rikaken2004/stm32-counter-motor-control_V3.0/FOOTPRINT_CHECKLIST.md

# FOOTPRINT CHECKLIST — 嘉立创 EDA 画板前封装确认

> 使用前请**逐项打勾**。每一项都必须在嘉立创 EDA 开始画符号/封装之前确认完毕。
> 所有信号名称以源代码 `hardware/*.c` 和 `user/*.c` 为准。

---

## 一、必须实物确认的模块

### 1. STM32F103C8T6 核心板 (Blue Pill / 兼容)

| # | 确认项 | 实测值/照片 | 已确认 |
|---|---|---|---|
| 1.1 | 排针 Pin 数: 2×20 = 40Pin | 标准 Blue Pill 为 2×20 | ☐ |
| 1.2 | 两排间距: 约 22.86mm (0.9 inch) | 卡尺实测 | ☐ |
| 1.3 | 排针间距: 2.54mm | 标准 2.54 | ☐ |
| 1.4 | **每个引脚的物理位置是否与原理图符号一致** | 拍照左右两侧排针，标注 Pin1 | ☐ |
| 1.5 | USB 口朝向 | 朝外/朝内？决定核心板摆放方向 | ☐ |
| 1.6 | BOOT0 / BOOT1 跳线位置 | 标注在照片上 | ☐ |
| 1.7 | RESET 按键位置 | 是否被 OLED / 其他模块遮挡？ | ☐ |
| 1.8 | SWD 口位置 (PA13/SWDIO, PA14/SWCLK) | 是否需要在 PCB 上再引出 SWD 排针？ | ☐ |
| 1.9 | 是否在 PCB 丝印上标注核心板方向 | 建议画一个箭头 + "USB→" | ☐ |

> **源代码验证**: 当前代码使用 PB8/PB9/PB12/PB13/PB14/PB1 (GPIOB), PA6/PA9/PA10 (GPIOA), PC13 (GPIOC)。均为 STM32F103C8T6 LQFP48 标准引脚。Blue Pill 引出全部 40 个 I/O。

### 2. TB6612FNG 电机驱动模块

| # | 确认项 | 实测值/照片 | 已确认 |
|---|---|---|---|
| 2.1 | 模块总排针数 | 拍照正面，标注每根针的功能 | ☐ |
| 2.2 | VM (电机电源) 位置 | 电压范围？(典型 2.5V~13.5V) | ☐ |
| 2.3 | VCC (逻辑电源) 位置 | 接 3.3V 还是 5V？ | ☐ |
| 2.4 | GND 位置 | 至少 1 个 GND 引脚 | ☐ |
| 2.5 | PWMA 位置 | 接 STM32 PA6 (TIM3_CH1) | ☐ |
| 2.6 | AIN1 位置 | 接 STM32 PB12 | ☐ |
| 2.7 | AIN2 位置 | 接 STM32 PB13 | ☐ |
| 2.8 | STBY 位置 | **代码未控制此引脚**，需确认模块是否已默认拉高 | ☐ |
| 2.9 | 如果 STBY 未默认拉高 | 需在 PCB 上接到 3.3V/VCC，或使用跳线帽 | ☐ |
| 2.10 | AO1/AO2 位置 | 电机输出 A 通道 | ☐ |
| 2.11 | 电机输出端位置 | 是否需要额外 2P 接线端子引出？ | ☐ |
| 2.12 | B 通道引脚 (BIN1/BIN2/PWMB/BO1/BO2) 位置 | V1 不使用 B 通道，标注为 NC | ☐ |

> **源代码验证**: `hardware/Motor.c:31-33`:
> - 正转/停止: PB12=H, PB13=L, `PWM_SetCompare1(Speed)` → PA6 PWM 占空比 = Speed%
> - 反转: PB12=L, PB13=H, `PWM_SetCompare1(-Speed)`
> - `PWM_Init()` 配置 TIM3_CH1 (PA6), ARR=99 → PWM 频率 ≈ 1kHz

### 3. OLED 0.96 寸 I2C 显示屏

| # | 确认项 | 实测值/照片 | 已确认 |
|---|---|---|---|
| 3.1 | **4Pin 引脚顺序（关键！）** | GND/VCC/SCL/SDA 还是 VCC/GND/SCL/SDA？ | ☐ |
| 3.2 | 拍照确认 Pin1 标识 | 丝印上通常有 VCC/GND 标记 | ☐ |
| 3.3 | 供电电压 | 3.3V 是否可正常点亮？还是必须 5V？ | ☐ |
| 3.4 | 接口方向 | 排针朝外还是朝上？方便杜邦线插拔 | ☐ |
| 3.5 | PCB 上 OLED 位置 | 是否考虑 4Pin 接口旁边标注 "GND/VCC/SCL/SDA" 丝印 | ☐ |

> **源代码验证**: `hardware/OLED.c:5-6`:
> - PB8 = SCL (`OLED_W_SCL(x) → GPIOB, Pin_8`)
> - PB9 = SDA (`OLED_W_SDA(x) → GPIOB, Pin_9`)
> - 配置为 `GPIO_Mode_Out_OD`（开漏输出，软件 I2C），无硬件 I2C 外设
>
> ⚠ 注意: 不同厂商 OLED 模块排针顺序不同！**必须拍照实物确认 Pin1 是 GND 还是 VCC，反接可能烧模块。**

### 4. 红外计数传感器

| # | 确认项 | 实测值/照片 | 已确认 |
|---|---|---|---|
| 4.1 | 3Pin 顺序 | VCC / GND / OUT | ☐ |
| 4.2 | 模块型号 | 红外对射？反射式？槽型光耦？ | ☐ |
| 4.3 | 供电电压 | 3.3V 还是 5V？ | ☐ |
| 4.4 | OUT 默认电平 | **高电平**（未触发），触发后**拉低** | ☐ |
| 4.5 | OUT 信号类型 | 数字开关量（非模拟） | ☐ |
| 4.6 | 是否需要 PB14 串联 1kΩ | 建议预留 0805 焊盘 | ☐ |
| 4.7 | 是否需要 PB14 上拉 10kΩ | 源码已配置内部上拉 (GPIO_IPU ≈ 40kΩ)，外部作为加固可选 | ☐ |
| 4.8 | 传感器安装方式 | 固定在 PCB 上还是外接延长线？ | ☐ |

> **源代码验证**: `hardware/CountSensor.c`:
> - 配置为 `GPIO_Mode_IPU`（内部上拉输入）
> - EXTI14 触发方式: `EXTI_Trigger_Falling`（下降沿）
> - ISR 中二次确认: `GPIO_ReadInputDataBit(GPIOB, GPIO_Pin_14) == 0`
> - **结论**: 红外传感器 OUT 默认高电平，检测到物体后拉低 → 下降沿触发计数。兼容 NPN 开集输出和推挽低有效输出。

### 5. USB-TTL 调试接口

| # | 确认项 | 说明 | 已确认 |
|---|---|---|---|
| 5.1 | 接口排针: GND / TX / RX / 3.3V | 4Pin 或 3Pin (无 3.3V) | ☐ |
| 5.2 | **丝印标注规则（关键！）** | `PB10_TX` = STM32 发送端 → 接 USB-TTL **RXD** | ☐ |
| 5.3 | | `PB11_RX` = STM32 接收端 → 接 USB-TTL **TXD** | ☐ |
| 5.4 | GND 丝印 | 清晰标注 | ☐ |
| 5.5 | 3.3V 丝印 | 标注 "3.3V (可选，通常不接)" | ☐ |
| 5.6 | **禁止丝印** | 不要标注 5V，防止误接烧 STM32 | ☐ |
| 5.7 | **不要从 USB-TTL 给 STM32 供电** | 在丝印上加注 "DO NOT POWER FROM UART" | ☐ |

> **源代码验证**: `user/uart_debug.c:11-15`: PB10 配置为 `GPIO_Mode_AF_PP` (USART3_TX), PB11 配置为 `GPIO_Mode_IN_FLOATING` (USART3_RX)。当前 TX 活跃使用，RX 初始化但未使用中断接收。

### 6. 电机接口

| # | 确认项 | 说明 | 已确认 |
|---|---|---|---|
| 6.1 | 接线端子类型 | 2P 螺钉端子 (5.08mm 或 3.5mm 间距) | ☐ |
| 6.2 | MOTOR_A+ → TB6612 AO1 | 丝印标注 "M+" | ☐ |
| 6.3 | MOTOR_A- → TB6612 AO2 | 丝印标注 "M-" | ☐ |
| 6.4 | 端子方向 | 朝板边，方便螺丝刀操作 | ☐ |
| 6.5 | 电机两端是否预留 0.1μF 电容焊盘 | 0805 或直插，直接并联在端子上 | ☐ |

> **源代码验证**: `hardware/Motor.c:29-41`: 电机方向由 PB12/PB13 控制，速度由 PA6 PWM 控制。M+/M- 只是功率输出，与代码无关。

### 7. 电机电源接口

| # | 确认项 | 说明 | 已确认 |
|---|---|---|---|
| 7.1 | 接线端子类型 | 2P 螺钉端子 (5.08mm 或 3.5mm 间距) | ☐ |
| 7.2 | VM 正极 | 丝印标注 "VM+" 或 "MOTOR_VCC" | ☐ |
| 7.3 | GND 负极 | 丝印标注 "GND" | ☐ |
| 7.4 | 电解电容位置 | 靠近 VM/GND 端子，径向引线封装 | ☐ |
| 7.5 | 电解电容值 | 100μF~470μF / 16V 或更高 | ☐ |
| 7.6 | 陶瓷电容位置 | 紧贴 VM/GND，0805 0.1μF | ☐ |
| 7.7 | 丝印标注电容极性 | 电解电容正极标 "+" | ☐ |
| 7.8 | 端子方向 | 朝板边 | ☐ |

### 8. 按键和 LED

| # | 确认项 | 说明 | 已确认 |
|---|---|---|---|
| 8.1 | PB1 ADD 按键封装 | 6×6mm 轻触开关 (4Pin 直插) | ☐ |
| 8.2 | PC13 CONFIRM/RESET 按键封装 | 6×6mm 轻触开关 (4Pin 直插) | ☐ |
| 8.3 | 按键是否需外部上拉 | **不需要**。源码已配置 GPIO_IPU (内部上拉 ≈40kΩ) | ☐ |
| 8.4 | 可预留 10kΩ 上拉焊盘 | 0805，默认不焊 | ☐ |
| 8.5 | PA9 LED9 (计数指示) | 5mm LED 直插，或者 0805 贴片 LED | ☐ |
| 8.6 | PA10 LED10 (状态指示) | 同上 | ☐ |
| 8.7 | **LED 点亮方式** | 低电平亮。PA9/PA10 输出低 → LED 导通 | ☐ |
| 8.8 | LED 限流电阻 | 220Ω~470Ω（3.3V 供电, 5mm 红色 LED, Vf≈1.8V, If≈5mA→R≈300Ω） | ☐ |
| 8.9 | LED 和电阻位置 | 靠近板边，方便观察 | ☐ |

> **源代码验证**:
> - `hardware/Key.c:16-17`: PB1 和 PC13 均配置 `GPIO_Mode_IPU`（内部上拉）。按键接 GND，按下时拉低。
> - `hardware/LED.c:40,104`: `GPIO_ResetBits(GPIOA, GPIO_Pin_9)` = 低电平 = LED **亮**; `GPIO_SetBits(GPIOA, GPIO_Pin_9)` = 高电平 = LED **灭**。

---

## 二、嘉立创 EDA 中建议的封装类型

| 元件 | 建议封装 | 嘉立创 EDA 搜索关键词 | 备注 |
|---|---|---|---|
| STM32 核心板排母 (单排) | 1×20Pin 排母, 2.54mm | `HDR-20X1-2.54` 或 `排母 1*20` | 需要 2 个 |
| STM32 核心板排母 (双排) | 2×20Pin 排母, 2.54mm | `HDR-20X2-2.54` 或 `排母 2*20` | 如用一体双排排母 |
| TB6612 模块排母 | 根据实测 Pin 数和排列 | `排母 1*N` | 拍照确认后再选 |
| OLED 4Pin 接口 | 1×4Pin 排针, 2.54mm | `HDR-4X1-2.54` | 或直接用排母 |
| 红外传感器 3Pin 接口 | 1×3Pin 排针, 2.54mm | `HDR-3X1-2.54` | 或 XH2.54-3P 弯针 |
| UART 调试接口 | 1×4Pin 排针, 2.54mm | `HDR-4X1-2.54` | 弯针或直针 |
| 电机接线端子 | 2P 螺钉端子, 5.08mm | `端子 5.08 2P` 或 `KF301-2P` | 两套: 电机输出 + 电机电源 |
| 按键 | 6×6mm 轻触开关, 4Pin | `轻触开关 6*6` 或 `TS-1187` | 2 个 |
| LED (直插) | 5mm LED, 2Pin | `LED 5mm` 或 `LED-TH-5MM` | 2 个 |
| LED (贴片) | 0805 LED | `LED-0805` | 备选 |
| 限流电阻 | 0805 或 直插 1/4W | `R-0805` 或 `RES-AXIAL` | 220Ω~470Ω |
| 电解电容 | 径向引线, Ø8~10mm | `CAP-ALU-RADIAL` | 100μF~470μF |
| 0.1μF 电容 | 0805 | `C-0805` | 或 直插 104 |
| PB14 串联电阻 | 0805 1kΩ | `R-0805` | 预留 |
| 测试点 | 1×1Pin 排针 或 测试环 | `测试点` 或 `TEST-POINT` | ~6 个 |

---

## 三、画板前必须拍照/测量清单

> 以下照片用于在 EDA 中绘制正确的封装和确认接口方向。

| # | 拍照/测量项 | 用途 | 已拍 |
|---|---|---|---|
| 3.1 | **STM32 核心板正面 + 背面** | 标注每个引脚的物理位置，确认 Pin1 | ☐ |
| 3.2 | **STM32 核心板侧面** | 测量两排排针间距（卡尺） | ☐ |
| 3.3 | **TB6612 模块正面 + 背面** | 标注每个引脚功能 (VM/VCC/GND/PWMA/AIN1/AIN2/STBY/AO1/AO2) | ☐ |
| 3.4 | **OLED 模块接口特写** | 看清 Pin1 标识和 GND/VCC/SCL/SDA 顺序 | ☐ |
| 3.5 | **红外传感器模块正反面** | 标注 VCC/GND/OUT 顺序 | ☐ |
| 3.6 | **USB-TTL 模块接口** | 确认 TXD/RXD/GND/3.3V/5V 标注方式 | ☐ |
| 3.7 | **电机 + 电机驱动板连接现状** | 参考当前杜邦线连接方式 | ☐ |
| 3.8 | **所有模块放在一起的俯视图** | 参考大致的物理布局 | ☐ |
| 3.9 | **卡尺/尺子放在旁边做比例参考** | 辅助确定 PCB 尺寸 | ☐ |

---

## 四、最容易画错的地方

| # | 风险项 | 后果 | 防范措施 |
|---|---|---|---|
| 4.1 | **核心板排母镜像** | 所有引脚左右互换，PCB 报废 | 拍照确认实物；EDA 中 3D 预览核对 Pin1 位置 |
| 4.2 | **OLED VCC/GND 反接** | 烧 OLED 模块 | 拍照确认 Pin1；丝印标注 GND 位置 |
| 4.3 | **TB6612 VM / VCC 混淆** | VM 接 3.3V 驱动不了电机；VCC 接 12V 烧模块 | 原理图中用不同网络名: `VMOTOR` vs `+3.3V` |
| 4.4 | **TX/RX 命名混淆** | 串口无输出 | 丝印标注 "PB10_TX → 接 USB-TTL RXD" |
| 4.5 | **电机电源和逻辑电源混淆** | 烧 STM32 或驱动无力 | 原理图中电源网络隔离；PCB 上分区走线 |
| 4.6 | **GND 未共地** | 电机不转或计数异常 | 原理图中所有 GND 为同一网络；PCB 上单点共地 |
| 4.7 | **电解电容极性反** | 电容爆裂 | 丝印标注 "+"；PCB 封装正极焊盘为方形 |
| 4.8 | **接线端子方向朝内** | 螺丝刀伸不进去 | 3D 预览确认端子开口朝板外 |
| 4.9 | **红外信号线与电机 PWM 线平行** | EMI 干扰重演 | PCB 布线后检查 PB14 走线不靠近 PA6/PB12/PB13 |
| 4.10 | **排母引脚编号与原理图符号不一致** | 所有信号错位 | EDA 原理图符号必须对照实物引脚编号 |
| 4.11 | **没有给 SWD 留测试点** | 无法烧录/调试 | 从核心板排母引 PA13/PA14 到 2Pin 排针（可选） |

---

## 五、下单前检查清单

> 嘉立创 EDA → 设计 → 设计规则检查 → 通过后逐项打勾。

### 电气规则 (ERC)

| # | 检查项 | 通过 |
|---|---|---|
| 5.1 | ERC 通过，0 错误 | ☐ |
| 5.2 | 所有电源网络有明确的源和负载 | ☐ |
| 5.3 | 无悬空输入引脚 (除了已预留的 NC) | ☐ |

### 设计规则 (DRC)

| # | 检查项 | 通过 |
|---|---|---|
| 5.4 | DRC 通过，0 错误 | ☐ |
| 5.5 | 最小线宽 ≥ 10mil (信号), ≥ 40mil (电源) | ☐ |
| 5.6 | 最小间距 ≥ 8mil | ☐ |
| 5.7 | 过孔尺寸 ≥ 0.6mm 内径 / 1.0mm 外径 | ☐ |

### 3D 预览

| # | 检查项 | 通过 |
|---|---|---|
| 5.8 | **STM32 核心板方向正确** — USB 口朝预期方向 | ☐ |
| 5.9 | OLED 排针顺序与实物一致 | ☐ |
| 5.10 | TB6612 排针顺序与实物一致 | ☐ |
| 5.11 | 接线端子开口朝板边 | ☐ |
| 5.12 | 按键不被 OLED 或其他模块遮挡 | ☐ |
| 5.13 | LED 位置可见（不被排针遮挡） | ☐ |

### 丝印

| # | 检查项 | 通过 |
|---|---|---|
| 5.14 | 电源正负极标注清晰 (VM+, GND, 3.3V, 5V) | ☐ |
| 5.15 | 电解电容正极标 "+" | ☐ |
| 5.16 | UART 接口: "PB10_TX → RXD", "PB11_RX ← TXD" | ☐ |
| 5.17 | 蜂鸣标注: "DO NOT POWER FROM UART" | ☐ |
| 5.18 | LED 标注: 低电平亮 | ☐ |

### 布局

| # | 检查项 | 通过 |
|---|---|---|
| 5.19 | 电机电源区和 MCU 区分区明显 | ☐ |
| 5.20 | 电机线靠板边，加粗走线 | ☐ |
| 5.21 | 红外接口远离电机 PWM / 电机电源走线 | ☐ |
| 5.22 | GND 铺铜 (顶层 + 底层) | ☐ |
| 5.23 | 电容靠近对应 IC/端子 | ☐ |

### 测试点

| # | 测试点 | 通过 |
|---|---|---|
| 5.24 | 3.3V | ☐ |
| 5.25 | GND (至少 2 个) | ☐ |
| 5.26 | PB14 (红外信号) | ☐ |
| 5.27 | PB10 (UART TX) | ☐ |
| 5.28 | PA6 (PWM) | ☐ |
| 5.29 | VM (电机电压) | ☐ |

---

*本文档状态: 所有项待确认。画原理图前务必完成第一章和第三章。*
