rikaken2004/stm32-counter-motor-control_V3.0/PROJECT_COMPLETION_CHECKLIST.md

# PROJECT COMPLETION CHECKLIST

## 一、项目最终定位

**项目名称**：STM32 智能计数与电机控制系统 —— 51 双 MCU 项目的 STM32 工程化升级版

**定位说明**：

| 维度 | 说明 |
|---|---|
| V1 目标 | 完成 STM32 单 MCU 工程化重构，实现原 51 双 MCU 的核心功能 |
| 显示方式 | V1 使用 OLED；数码管作为 V1.5/V2 扩展 |
| 双机通信 | 不在 V1 迁移。STM32 单 MCU 已能完成原双 51 的功能 |
| FreeRTOS | 不在 V1 合入。作为 V2 可选升级 |
| 非目标 | V1 不是完全复刻 51 的数码管和双机通信 |

## 二、V1 必须完成的功能清单

### 已完成 ✅

| # | 功能 | 状态 |
|---|---|---|
| 1 | OLED 显示目标值(T)、当前计数(C)、累计值(Total)、状态(State)、电机状态(Motor) | ✅ 已实现 |
| 2 | PB1 按键设置目标值 (0~99 循环) | ✅ 已实现 |
| 3 | PC13 短按确认/复位，长按复位 (>2s) | ✅ 已实现 |
| 4 | PB14 红外 EXTI 下降沿计数 | ✅ 已实现 |
| 5 | TIM4 1ms 非阻塞时基 (`App_Millis`) | ✅ 已实现 |
| 6 | app_key 非阻塞按键消抖 (10ms 采样, 3 次确认) | ✅ 已实现 |
| 7 | app.c IDLE / RUNNING / COOLDOWN 状态机 | ✅ 已实现 |
| 8 | TIM3 PWM 电机调速 (PA6, 60% 占空比, PB12/PB13 方向) | ✅ 已实现 |
| 9 | USART3 PB10/PB11 调试日志 (启动/按键/状态转换/IR 计数事件) | ✅ 已实现 |
| 10 | app 层 IR 120ms 防抖过滤 | ✅ 已实现 |
| 11 | PA9 LED 计数闪烁 (50ms), PA10 LED COOLDOWN 常亮 | ✅ 已实现 |
| 12 | COOLDOWN 5s 后自动重启电机进入下一轮 | ✅ 已实现 |

### 待完成 🔲

| # | 功能 | 状态 | 备注 |
|---|---|---|---|
| 13 | 电机接入后的抗干扰整改 | 🔲 待硬件处理 | 见第三章 |
| 14 | 稳定运行测试 (连续 10~30 分钟) | 🔲 待硬件整改后 | 见第七章 |

## 三、V1 硬件整改清单

> 所有项目均待执行。目标：消除电机对 PB14 红外计数的 EMI 干扰。

| # | 整改项 | 状态 | 说明 |
|---|---|---|---|
| 1 | 电机单独供电 | 🔲 | 电机驱动板 VM 使用独立电源，不与 STM32 共用 |
| 2 | STM32 与电机驱动共地 | 🔲 | GND 相连，但电源隔离 |
| 3 | 电机驱动 VM/GND 并联 100μF~470μF 电解电容 | 🔲 | 吸收电机启停电流尖峰 |
| 4 | VM/GND 附近并联 0.1μF 陶瓷电容 | 🔲 | 滤除高频噪声 |
| 5 | 电机两端并联 0.1μF 陶瓷电容 | 🔲 | 直接焊在电机接线端子上 |
| 6 | 红外 OUT → PB14 预留 1kΩ 串联电阻 | 🔲 | 限流 + 低通滤波 |
| 7 | PB14 预留 10kΩ 上拉到 3.3V | 🔲 | 确保无信号时电平确定 |
| 8 | 红外信号线远离电机线 | 🔲 | 物理隔离，避免平行走线 |
| 9 | 电机电源线加粗、缩短 | 🔲 | 减小回路阻抗和辐射面积 |
| 10 | GND 回流路径避免穿过 MCU 信号区 | 🔲 | 单点接地或星型接地 |

## 四、PCB V1 设计清单

> V1 定义为模块化载板，使用现成核心板 + 模块，非 STM32 裸芯片板。

### 板载接口 🔲

| # | 项目 | 状态 | 说明 |
|---|---|---|---|
| 1 | STM32F103C8T6 核心板插座 | 🔲 | 2×20 排母，接入 Blue Pill / 最小系统板 |
| 2 | TB6612FNG 电机驱动模块插座 | 🔲 | 排针/排母接口 |
| 3 | OLED 4Pin 接口 (VCC/GND/SCL/SDA) | 🔲 | 2.54mm 排针 |
| 4 | 红外传感器 3Pin 接口 (VCC/GND/OUT) | 🔲 | 2.54mm 排针 |
| 5 | PB1 按键 (ADD) | 🔲 | 微动开关 + 上拉电阻 |
| 6 | PC13 按键 (CONFIRM) | 🔲 | 微动开关 + 上拉电阻 |
| 7 | PA9 LED (计数指示) | 🔲 | 5mm LED + 限流电阻 |
| 8 | PA10 LED (冷却指示) | 🔲 | 5mm LED + 限流电阻 |
| 9 | USART3 调试接口 (PB10/PB11) | 🔲 | 4Pin (VCC/GND/TX/RX) 排针，兼容 USB-TTL |
| 10 | 电机接线端子 | 🔲 | 2P 螺钉端子 |
| 11 | 电机电源输入端子 | 🔲 | 2P 螺钉端子，独立供电 |
| 12 | 逻辑电源接口 | 🔲 | 5V 输入，为 STM32 核心板供电 |

### 电容预留位 🔲

| # | 位置 | 状态 |
|---|---|---|
| 13 | 电机电源输入端：100μF~470μF 电解电容焊盘 | 🔲 |
| 14 | 电机电源输入端：0.1μF 0805 陶瓷电容焊盘 | 🔲 |
| 15 | PB14 输入端：100nF 对地电容焊盘 | 🔲 |

### PCB 设计要求 🔲

| # | 项目 | 状态 |
|---|---|---|
| 16 | GND 铺铜 (顶层 + 底层) | 🔲 |
| 17 | 测试点：3.3V、5V、GND、PB14、PB10、PA6 | 🔲 |
| 18 | 嘉立创 EDA 设计，打样 10cm×10cm 以内 | 🔲 |

## 五、V1 不做清单

> 明确排除，避免范围蔓延。

| # | 项目 | 原因 |
|---|---|---|
| 1 | STM32 裸芯片板 | V1 用核心板+模块载板，降低门槛 |
| 2 | 板载 ST-LINK | 使用外接 ST-Link V2 / USB-TTL |
| 3 | 复杂电源管理 | V1 不做 DC-DC / LDO 电路，模块自带 |
| 4 | 数码管主显示 | V1 用 OLED；数码管放 V1.5 |
| 5 | 双 MCU 主从通信 | STM32 单 MCU 已覆盖原双 51 功能 |
| 6 | FreeRTOS 合入 | 放 V2，V1 保持裸机 |
| 7 | DMA 数码管扫描 | 无数码管则不需 |
| 8 | Flash 参数保存 | V1 参数不持久化，每次上电重置 |
| 9 | 外壳结构 | 仅做板级验证 |

## 六、V1.5 / V2 可选升级

### V1.5 — 显示扩展 🔲

| # | 项目 | 说明 |
|---|---|---|
| 1 | 数码管显示扩展 | 显示当前计数 / 目标值 |
| 2 | TM1637 方案 | 4 位 / 6 位数码管，I2C 类协议，2 线 |
| 3 | MAX7219 方案 | 8 位数码管，SPI，可级联 |
| 4 | 74HC595 方案 | 低成本，需 3 线 + 软件扫描 |
| 5 | 保留 OLED 主显示 | OLED 显示状态/菜单，数码管显示数值 |

### V2 — FreeRTOS 任务化 🔲

| # | 项目 | 说明 |
|---|---|---|
| 1 | FreeRTOS 移植 | CMSIS-RTOS v1/v2 API |
| 2 | KeyTask | 按键扫描任务，发送事件到 Queue |
| 3 | SensorTask | 红外计数任务，semaphore 通知 |
| 4 | MotorTask | 电机控制任务，接收速度/方向命令 |
| 5 | DisplayTask | OLED 刷新任务，100ms 周期 |
| 6 | DebugTask | UART 日志任务，Queue 接收消息后发送 |
| 7 | AppTask | 状态机任务，EventGroup 协调各任务 |
| 8 | UART 日志改队列发送 | 避免阻塞式 TX，解耦日志与发送 |
| 9 | 参数设置菜单 | OLED 菜单 + 按键导航，设置电机速度/冷却时间/目标上限 |

## 七、验证清单

### 基础功能测试

| # | 测试项 | 状态 | 通过条件 |
|---|---|---|---|
| 1 | 上电 OLED 显示正常 | 🔲 | 4 行内容清晰，State: IDLE, Motor: OFF |
| 2 | PB1 加值正常 | 🔲 | T 值 0→1→2...→99→0 循环 |
| 3 | PC13 短按启动 | 🔲 | T>0 时 RUNNING, 电机转动 |
| 4 | PC13 长按复位 | 🔲 | 任意状态 >2s 按回 IDLE |
| 5 | 红外计数正常 | 🔲 | PB14 有脉冲时 C 值递增 |
| 6 | 达标进入冷却 | 🔲 | C≥T 时电机停, LED10 亮, State: COOL |
| 7 | 冷却 5s 自动重启 | 🔲 | 5s 后自动回 RUNNING, 电机启动 |
| 8 | RUNNING 中复位 | 🔲 | 短按/长按均回 IDLE, 电机停 |
| 9 | COOLDOWN 中复位 | 🔲 | 短按/长按均回 IDLE, 电机停 |
| 10 | UART 日志正常 | 🔲 | 串口助手可收到 7 种事件日志 |

### 红外计数精度测试 (不接电机)

| # | 测试项 | 状态 | 通过条件 |
|---|---|---|---|
| 11 | 不接电机，红外计数稳定 | 🔲 | raw=1, 无异常跳变 |

### 电机 + 红外联合测试 (接电机)

| # | 测试项 | 状态 | 通过条件 |
|---|---|---|---|
| 12 | 接电机后红外无异常大脉冲 | 🔲 | raw 无 20+ 的异常值 |
| 13 | T=1 连续 10 轮 | 🔲 | 每轮正常完成, 无复位 |
| 14 | T=3 连续 10 轮 | 🔲 | 每轮正常完成, 无复位 |
| 15 | T=5 连续 10 轮 | 🔲 | 每轮正常完成, 无复位 |

### 稳定性测试

| # | 测试项 | 状态 | 通过条件 |
|---|---|---|---|
| 16 | OLED 无卡死 | 🔲 | 显示持续刷新, 无冻结/乱码 |
| 17 | UART 日志无异常 | 🔲 | 日志格式正确, 无乱码/丢帧 |
| 18 | 电机启停无复位 | 🔲 | 启停瞬间 STM32 不重启 |
| 19 | 连续运行 10~30 分钟 | 🔲 | 无异常复位/死机 |

## 八、简历交付物清单

| # | 交付物 | 状态 | 说明 |
|---|---|---|---|
| 1 | 项目 README | 🔲 | 项目概述、功能列表、硬件接线、编译烧录 |
| 2 | 状态机图 | 🔲 | IDLE→RUNNING→COOLDOWN 转换图 |
| 3 | 引脚表 PINMAP | 🔲 | 已存在于 PROJECT_CONTEXT.md |
| 4 | 原理图截图 | 🔲 | 嘉立创 EDA 导出 |
| 5 | PCB 3D 预览图 | 🔲 | 嘉立创 EDA 3D 视图截图 |
| 6 | 实物照片 | 🔲 | 模块搭建 + PCB 版本各一张 |
| 7 | 演示视频 | 🔲 | 完整工作流程: 设置→启动→计数→停止→冷却→重启 |
| 8 | 串口日志截图 | 🔲 | 包含 7 种事件日志的完整截图 |
| 9 | 电机干扰定位记录 | 🔲 | 干扰现象 + 整改方案 + 整改前后对比 |
| 10 | Git 本地提交记录 | 🔲 | 清晰的 commit history |

## 九、简历项目描述草稿

> 可用于简历「项目经历」栏，建议 4~6 行。

**STM32 智能计数与电机控制系统**

- 基于 STM32F103C8T6 的工业计数控制项目，是 51 双 MCU 方案的 STM32 单芯片工程化升级
- 设计 IDLE / RUNNING / COOLDOWN 三层非阻塞状态机，基于 TIM4 1ms 时基驱动，零 `Delay_ms` 裸机架构
- EXTI 下降沿红外脉冲计数 + 软件消抖，TIM3 PWM 电机调速 (TB6612 驱动)，按键消抖采用 10ms 采样 3 次确认状态机
- USART3 115200bps 事件日志 (启动/状态转换/计数/复位)，用于调试和运行监控
- 定位并整改电机 EMI 干扰红外信号问题：独立供电、RC 滤波、PCB 布局优化
- 使用 Keil MDK + STM32 标准外设库开发，嘉立创 EDA 设计模块化载板 PCB

**英文版 (可选)**：

- STM32F103C8T6-based industrial counting & motor control system; single-MCU upgrade from a dual-8051 design
- Designed a 3-state non-blocking state machine (IDLE→RUNNING→COOLDOWN) driven by TIM4 1ms tick, zero blocking delays
- EXTI-based IR pulse counting with software debounce; TIM3 PWM motor speed control via TB6612 driver
- USART3 115200bps event logging for debugging and runtime monitoring
- Diagnosed and resolved motor EMI interference on the IR sensor signal through isolated power, RC filtering, and PCB layout improvements
- Developed with Keil MDK + STM32 Standard Peripheral Library; modular carrier board PCB designed in EasyEDA

---

*本文档状态：规划中。V1 软件功能基本完成，硬件整改和验证待进行。*
