rikaken2004/stm32-counter-motor-control_V3.0/PROJECT_CONTEXT.md

# PROJECT CONTEXT — STM32 计数器项目

## 项目概述

基于 STM32F103 的计数/定长控制系统。传感器脉冲计数，达到目标值后电机自动停止，冷却后自动重启，循环运行。

## 目录结构

```
STM32_COUNTER_PROJECT/
└── 2-1/                          # Keil MDK 工程目录
    ├── project.uvprojx           # Keil 工程文件
    ├── user/                     # 应用层
    │   ├── main.c                # 入口
    │   ├── app.h / app.c         # 状态机 & 任务调度
    │   ├── app_time.h / app_time.c   # 非阻塞时基 (TIM4)
    │   ├── app_key.h / app_key.c     # 非阻塞按键
    │   ├── uart_debug.h / uart_debug.c  # USART3 调试输出
    │   ├── stm32f10x_conf.h
    │   └── stm32f10x_it.c/h
    ├── hardware/                 # 外设驱动（不可修改）
    │   ├── OLED.c/h, OLED_Font.h
    │   ├── Motor.c/h
    │   ├── PWM.c/h
    │   ├── LED.c/h, NEW_LED.c/h
    │   ├── Key.c/h
    │   ├── CountSensor.c/h
    │   ├── Encoder.c/h, NEW_Encoder.c/h
    │   ├── IC.c/h
    │   ├── AD.c/h, New_AD.c/h
    │   ├── Buzzer.c/h
    │   ├── LightSensor.c/h
    │   └── Servo.c/h
    ├── system/                   # 系统工具（已存在，应用中未使用）
    │   ├── Delay.c/h
    │   ├── Timer.c/h
    │   ├── InternalTimer.c/h
    │   └── ExternalTimer.c/h
    ├── start/                    # 启动文件 & CMSIS
    └── library/                  # 标准外设库
```

## 当前实现功能

| 功能 | 说明 |
|---|---|
| 非阻塞时基 | TIM4 1ms 中断，`App_Millis()` 提供毫秒时间戳 |
| 非阻塞按键 | PB1 加值, PC13 短按确认/长按复位(>2s), 10ms 采样 + 3 次消抖 |
| 状态机 | IDLE → RUNNING → COOLDOWN → RUNNING 自动循环 |
| OLED 显示 | 100ms 刷新, 4 行: 目标/当前/累计/状态/电机 |
| 电机控制 | PWM 调速 60%, PA6(TIM3_CH1), 方向 PB12/PB13 |
| 计数传感器 | PB14 下降沿中断, delta 差值法, app 层 120ms 防抖过滤 |
| LED 指示 | PA9 每检测到一次计数闪 50ms, PA10 COOLDOWN 时常亮 |
| USART3 调试日志 | 启动日志 + 按键/状态转换/IR 计数事件日志, 115200 8N1 |

## 新增文件

| 文件 | 作用 |
|---|---|
| `user/app_time.h` | `App_Time_Init()`, `App_Millis()` |
| `user/app_time.c` | TIM4 配置 (PSC=71, ARR=999, 1kHz), `TIM4_IRQHandler` tick 自增 |
| `user/app_key.h` | `AppKeyEvent` 枚举, `App_Key_Init/Update/GetEvent` |
| `user/app_key.c` | 非阻塞状态机: PB1 单次触发, PC13 短/长按, 事件缓存 |
| `user/app.h` | `App_Init()`, `App_Task()` |
| `user/app.c` | 三层状态机 + delta 计数 + IR 防抖 + OLED 刷新 + LED 指示 + 事件日志 |
| `user/uart_debug.h` | `UART_Debug_Init/SendChar/SendString/SendNum` |
| `user/uart_debug.c` | USART3 PB10/PB11, 阻塞式 TX, 115200 8N1 |

## 修改文件

| 文件 | 变更 |
|---|---|
| `user/main.c` | 旧 AD 演示替换为 `App_Init()` + `while(1) App_Task()` |
| `project.uvprojx` | 补加 `Motor.c/h` 到 hardware 组; `app_time/app_key/app/uart_debug` 到 user 组 |

## 状态机

```
         ┌──────────────────────────────┐
         │   CONFIRM / RESET            │
         │   (清零, 停电机)              │
         ▼                              │
      ┌──────┐  CONFIRM(target>0)  ┌──────────┐
      │ IDLE │ ──────────────────→ │ RUNNING  │
      │      │                     │ 电机 ON   │
      └──────┘                     └──────────┘
         ▲                              │
         │                              │ current ≥ target
         │                              ▼
         │                        ┌───────────┐
         │   CONFIRM / RESET      │ COOLDOWN  │
         └─────────────────────── │ 电机 OFF   │
                                  │ LED10 ON  │
                                  └───────────┘
                                       │
                                       │ 5s 后
                                       │ 自动重启电机
                                       ▼
                                  ┌──────────┐
                                  │ RUNNING  │  (下一轮)
                                  └──────────┘
```

- **IDLE**: PB1(ADD) 调整 target_count (0~99 循环)，PC13 短按启动 (target>0 时)，PC13 长按清零
- **RUNNING**: 电机 60% 占空比运行，CountSensor delta 累加 current_count（app 层 120ms 防抖），每有效脉冲 PA9 闪 50ms，达标→COOLDOWN。CONFIRM/RESET 清零回 IDLE
- **COOLDOWN**: 电机停止，LED10 亮，等 5s → 自动清零 current_count 回 RUNNING。CONFIRM/RESET 清零回 IDLE

## 硬件引脚分配

| 模块 | 引脚 | 备注 |
|---|---|---|
| OLED I2C | PB8(SCL), PB9(SDA) | 软件 I2C |
| 电机 PWM | PA6 (TIM3_CH1) | `Motor_Init` 内部调用 `PWM_Init` |
| 电机方向 | PB12, PB13 | 推挽输出, `Motor_SetSpeed` 控制 |
| 计数传感器 | PB14 (EXTI14 下降沿) | 上拉输入, `CountSensor_Init/Get` |
| 按键 ADD | PB1 | 上拉输入, 低电平有效 |
| 按键 CONFIRM | PC13 | 上拉输入, 低电平有效 |
| LED9 | PA9 | 推挽输出, 低电平亮 |
| LED10 | PA10 | 推挽输出, 低电平亮 |
| USART3 TX | PB10 | 复用推挽, 115200 8N1 |
| USART3 RX | PB11 | 浮空输入（已初始化，未使用接收） |
| 时基 | TIM4 | PSC=71, ARR=999, 1ms 中断 |

## UART 调试日志

波特率 115200, 8N1。USART3 (PB10/PB11)，仅 TX 发送。

| 事件 | 日志格式 |
|---|---|
| 系统启动 | `STM32 counter system boot` |
| 按键加值 | `KEY ADD target=xx` |
| 确认启动 | `STATE IDLE->RUN target=xx` |
| 红外有效计数 | `IR raw=xx count=xx` |
| 达标进入冷却 | `STATE RUN->COOL total=xxxxx` |
| 冷却结束重启 | `STATE COOL->RUN` |
| 任意状态复位 | `RESET to IDLE` |

## 已知问题：电机干扰

### 现象

- 接入电机电源后，电机启动/运行会严重干扰 PB14 红外计数输入
- 串口日志出现 `IR raw=25`、`IR raw=30` 等异常大脉冲
- 可能导致 STM32 异常复位或主循环卡死（OLED 熄屏、系统停止响应）
- 断开电机电源后，仅保留 STM32、OLED、红外、按键、USB-TTL，计数恢复正常（raw=1）

### 根因分析

电机 PWM 驱动产生电磁干扰（EMI），通过以下路径影响 PB14：

1. **传导干扰**：电机和 STM32 共用电源，电机启停产生电压波动
2. **辐射干扰**：电机换向火花/高频 PWM 通过电磁场耦合到 PB14 信号线
3. **地弹**：电机大电流在地线上产生电压差，干扰红外传感器参考电平

当前的 app 层 120ms 红外防抖只能过滤计数增量，无法阻止 ISR 层面的中断风暴。

### 临时处理

- 后续软件开发和逻辑测试时**先断开电机电源**
- 只保留 STM32、OLED、红外、按键、USB-TTL 测试主逻辑
- 电机相关逻辑可正常开发，但验证时以无电机环境为准

### 后续硬件处理计划

1. **电机单独供电** — 电机驱动板使用独立电源，不与 STM32 共用
2. **共地** — STM32 与电机驱动板 GND 相连（仅地线，电源隔离）
3. **电机驱动 VM/GND 并联电解电容** — 100μF~470μF，吸收电机启停电流尖峰
4. **电机两端并联陶瓷电容** — 0.1μF (104)，滤除换向火花高频噪声
5. **信号线远离电机线** — PB14 红外信号线远离电机驱动线和电机本体
6. **PB14 输入端 RC 滤波** — 串联 1kΩ 电阻 + 对地 100nF 电容 + 10kΩ 上拉
7. **软件兜底** — app 层已加入 `APP_IR_DEBOUNCE_MS=120ms` 最小计数间隔过滤

## 当前限制

1. **CountSensor 需要外部脉冲源** — PB14 无脉冲时计数不增长
2. **App_Task 中 GetEvent 在 Update 之前调用** — 按键事件有 1 帧延迟（非致命）
3. **LED ON/OFF 函数每次重新初始化 GPIO** — 功能正确但低效
4. **system/ 和部分 hardware/ 旧驱动未清理** — 可编译但未使用
5. **电机干扰未硬件解决** — 当前接电机时系统不稳定，需断开电机测试
6. **无 printf 重定向** — 日志使用逐字符阻塞发送，波特率 115200
7. **无 USART 中断/DMA** — TX 为轮询等待 TXE 标志位

## 下一阶段计划（勿执行）

1. 硬件：电机独立供电 + 滤波电容 + 信号线隔离
2. 硬件：PB14 输入 RC 滤波
3. 修复 App_Task 中 Update/GetEvent 调用顺序
4. 数码管显示方案
5. DMA + ADC 非阻塞模拟量采集
6. 清理未使用的旧驱动文件
7. 嘉立创 EDA 原理图/PCB 设计
8. 参数可配置（电机速度、冷却时间、目标上限）

---

## PCB V1 焊接与首次上电调试记录

**日期**：2026-06-04

### 背景

PCB V1 已完成嘉立创下单并收到裸板。V1 采用**模块化载板方案**（STM32 核心板 + 各模块通过排针/插座接入），非裸 STM32 芯片板。

本次焊接使用**第一片 PCB 作为调试/练手板**，目标是先验证核心逻辑链路（STM32 → OLED → 按键 → 红外计数 → 状态机），而不是一次性完成电机全系统。

### 已验证通过 ✅

| # | 项目 | 状态 | 说明 |
|---|---|---|---|
| 1 | STM32 最小系统板上电 | ✅ | 核心板插接载板后正常上电，3.3V/5V 供电正常 |
| 2 | OLED 显示 | ✅ | 4 行显示正常，State/Motor 状态刷新正确 |
| 3 | ADD 按键（PB1/SW1） | ✅ | 可正常设置目标次数 0~99 循环 |
| 4 | CONFIRM/RESET 按键（PC13/SW2） | ✅ | 最初无响应，定位为 PC13 虚焊，补焊后恢复正常 |
| 5 | 主状态机 | ✅ | IDLE → RUNNING → COOLDOWN → RUNNING 流程正常 |
| 6 | 红外传感器计数 | ✅ | 传感器触发后 OLED 计数显示正常变化 |
| 7 | PCB 逻辑部分核心功能 | ✅ | 基本验证通过 |

### 调试发现的问题 🔧

| # | 问题 | 现象 | 处理 |
|---|---|---|---|
| 1 | **PC13 虚焊** | SW2/PC13 电平异常，确认键完全无响应 | 补焊 PC13 引脚后恢复正常 |
| 2 | **电机输出接口 U2 焊盘损伤** | 未安装 KF301 接线端子，直接焊线导致焊盘受损 | 暂停继续硬焊，等待接线端子到货 |
| 3 | **0805 LED 及贴片元件未就绪** | LED 及相关阻容未完全到货/焊接条件不足 | LED 暂不作为核心功能验证项 |
| 4 | **TB6612 发热/异常** | 电机驱动供电测试中出现驱动芯片异常发热 | 暂停电机测试，等待规范供电接线 |

### 当前结论

- **PCB V1 不是废板**。STM32、OLED、按键、红外计数、主状态机等核心逻辑链路已经跑通。
- 当前主要问题集中在**焊接装配**、**接线端子缺失**、**电机供电测试条件不规范**，而不是主控逻辑或 PCB 整体网络失败。
- PCB 的网络连接（引脚分配、电源、信号线）设计已被验证可用。

### 后续计划

1. **暂停继续硬焊电机输出接口**，避免扩大 U2 焊盘损伤。
2. **等待元件到货**：KF301-5.0-2P 接线端子、0805 LED、0805 阻容等。
3. **使用第二片 PCB 作为正式焊接板**，按分阶段顺序验证：
   - 第一阶段：逻辑部分（STM32 + OLED + 按键）
   - 第二阶段：红外传感器计数
   - 第三阶段：电机驱动（TB6612 + PWM）
   - 第四阶段：电机电源 + 全系统联合
4. **记录 V1.1 改进点**：
   - LED 可考虑改为直插 LED（方便手工焊接）
   - 电机接口丝印加大（U1/U2 标识更明显）
   - 关键测试点（3.3V、5V、GND、PB14、PA6）标记更明显
   - U1/U2 接线端子周围预留更好焊接空间（焊盘间距适当增大）
5. 第二片 PCB 调试通过后，整理完整的 PCB V1 验证报告。

---

## 红外计数与 LED 调试记录

**日期**：2026-06-08

### 背景

PCB V1 逻辑部分核心链路（STM32 + OLED + 按键 + 状态机）验证通过后，进入红外计数调试阶段。此阶段还将原 3Pin 红外传感器更换为 4Pin 模块（AO/DO/GND/VCC），使用 DO 数字输出接 PB14。

### 最初异常现象 🔴

| 现象 | 表现 |
|---|---|
| 传感器本体电压变化 | 万用表测传感器 OUT 端，遮挡/未遮挡时电压有变化 |
| OLED 计数不增加 | 反复遮挡传感器，OLED 上 C 值始终为 0 |
| 串口日志 PB14 lvl 恒为 1 | `PB14 lvl=1` 持续输出，无论遮挡与否都不变 |

### 排查过程

**第一步（误判）**：怀疑传感器输出电平异常。更换为 4Pin 模块后问题依旧，排除传感器本身故障。

**第二步（关键测量）**：分别测量 H4 OUT、R1 两端对 GND 电压：

| 测量点 | 未遮挡 | 遮挡 | 说明 |
|---|---|---|---|
| 传感器 OUT（H4 输入端） | ~0V | ~3V | ✅ 传感器输出正常，可稳定翻转 |
| R1 靠传感器侧 | ~0V | ~3V | ✅ 信号经过 R1 前正常 |
| R1 靠 PB14 侧（IR 测试点） | ~1.6V | ~3V | ❌ 低电平被抬高！ |

**第三步（定位根因）**：R1 后端 / PB14 侧低电平被抬高的原因是 **R2 上拉配置不合适**，导致 PB14 低电平从 0V 被拉到约 1.6V 中间电压。STM32F103 的 V_IH(min) = 2.145V、V_IL(max) = 1.155V，1.6V 处于不确定区域，STM32 实际读取为高电平，因此 `PB14 lvl` 始终为 1，上升沿中断永不触发。

### 临时修复方案

| 元件 | 处理 | 说明 |
|---|---|---|
| R2 | **暂时空着（不焊）** | 移除不当上拉，消除分压效应 |
| R1 | 保留当前临时配置 | 串联限流，保护 PB14 |
| C6 | 保留 | 去耦/滤波，不影响数字信号 |

修复后测量结果：

| 测量点 | 未遮挡 | 遮挡 |
|---|---|---|
| PB14 / IR 测试点 | ~0V | ~3V |
| 串口 `PB14 lvl` | `0` | `1` |

电平翻转干净、稳定，STM32 可正确识别。

### 软件侧配合

- 触发沿保持 **上升沿** `EXTI_Trigger_Rising`（未遮挡=0 → 遮挡=1 上升沿触发计数）
- `CountSensor_ReadRawLevel()` 和周期性 `PB14 lvl` 串口日志保留，用于持续监控
- 当前代码不需任何修改，红外触发后 OLED 计数已恢复正常

### LED 指示

之前 0805 LED 及相关贴片元件未就绪的问题也已解决，当前 **LED9（计数闪烁）和 LED10（COOLDOWN 常亮）均可正常工作**，与红外计数和状态机联动正确。

### 后续改进

1. 等 **10K 电阻到货**后，评估是否按原设计补焊 R2=10KΩ。若补焊，需验证 PB14 低电平是否仍保持在 V_IL(max)=1.155V 以下。
2. **V1.1 PCB 改进**：
   - 红外输入电路应明确标注 R1/R2/C6 各自的作用：
     - R1：串联限流/低通滤波
     - R2：上拉电阻（需根据传感器 DO 输出类型选择合适阻值，避免与 R1 形成分压把低电平抬高）
     - C6：对地滤波电容
   - IR 测试点（PB14 端）应更明显标注，方便万用表/示波器测量
   - 可考虑在红外接口处增加一个跳线帽，方便切换上拉/下拉/浮空配置
3. 将本次调试经验作为 V1 验证报告的一部分，供后续 PCB 改版参考。
