rikaken2004/stm32-counter-motor-control_V3.0/docs/bringup_log.md

# PCB V1 Bringup Log

## 背景

PCB V1 采用模块化载板方案。第一片 PCB 作为调试/练手板，目标是先验证核心逻辑链路。

## 第一阶段：核心逻辑验证 ✅

| # | 项目 | 状态 | 备注 |
|---|---|---|---|
| 1 | STM32 核心板上电 | ✅ | 3.3V/5V 供电正常 |
| 2 | OLED 显示 | ✅ | 4 行内容清晰 |
| 3 | ADD 按键 (PB1/SW1) | ✅ | 0~99 循环正常 |
| 4 | CONFIRM/RESET 按键 (PC13/SW2) | ⚠️→✅ | 初始无响应，PC13 虚焊，补焊后正常 |
| 5 | 主状态机 | ✅ | IDLE→COUNTING→MOTOR_RUN→DONE 流程完整 |
| 6 | 红外计数 | ⚠️→✅ | 初始 PB14 始终读为 1，R2 上拉不当→空焊解决 |
| 7 | LED 指示 | ✅ | LED9 计数闪烁, LED10 电机运行指示 |

## 第二阶段：红外计数调试

### 初始异常

- 传感器 OUT 端电压可正常变化 (~0V ↔ ~3V)
- 但 OLED 计数不增加
- 串口 PB14 lvl 始终为 1

### 排查过程

1. 怀疑传感器故障 → 更换 4Pin 模块，问题依旧 → 排除
2. 测量 R1 两端电压：传感器侧 ~0V/~3V，PB14 侧 ~1.6V/~3V
3. 定位根因：R2 上拉与 R1 形成分压，PB14 低电平被抬至 ~1.6V
4. STM32 V_IL(max)=1.155V, V_IH(min)=2.145V，1.6V 在不确定区，GPIO 判为高电平
5. **临时方案**：R2 空焊，保留 R1+C6

### 修复后

- PB14 电平：未遮挡 ~0V，遮挡 ~3V
- 串口 PB14 lvl 正常翻转 0↔1
- 上升沿触发计数正常

## 第三阶段：电机驱动

| # | 项目 | 状态 | 备注 |
|---|---|---|---|
| 1 | 电机输出接口 U2 | ⚠️ | 无接线端子直接焊线，焊盘受损 |
| 2 | TB6612 功能测试 | ⚠️ | 供电不规范导致发热异常 |
| 3 | 规范电机测试 | 🔲 | 等 KF301 端子 + 第二片 PCB |

## PCB V1 结论

- ✅ PCB 不是废板，核心逻辑链路已全部跑通
- ⚠️ 问题集中在焊接装配和供电规范，非 PCB 设计网络错误
- 🔲 第二片 PCB 将作为正式焊接板，分阶段验证

## V1.1 改进点

1. LED 改直插 (方便手工焊接)
2. 电机接口丝印加大 (U1/U2 标识)
3. 红外输入电路标注 R1/R2/C6 作用
4. 测试点更明显 (3.3V/5V/GND/PB14/PA6)
5. U1/U2 焊盘间距增大
