rikaken2004/stm32-counter-motor-control_V3.0/user/app_time.c

#include "stm32f10x.h"
#include "app_time.h"

volatile uint32_t sys_tick_ms;

void App_Time_Init(void)
{
	TIM_TimeBaseInitTypeDef TIM_TimeBaseInitStructure;
	NVIC_InitTypeDef NVIC_InitStructure;
    sys_tick_ms = 0;

    
    

    RCC_APB1PeriphClockCmd(RCC_APB1Periph_TIM4, ENABLE);

    TIM_InternalClockConfig(TIM4);

    TIM_TimeBaseInitStructure.TIM_ClockDivision = TIM_CKD_DIV1;
    TIM_TimeBaseInitStructure.TIM_CounterMode = TIM_CounterMode_Up;
    TIM_TimeBaseInitStructure.TIM_Period = 1000 - 1;
    TIM_TimeBaseInitStructure.TIM_Prescaler = 72 - 1;
    TIM_TimeBaseInitStructure.TIM_RepetitionCounter = 0;
    TIM_TimeBaseInit(TIM4, &TIM_TimeBaseInitStructure);

    TIM_ClearFlag(TIM4, TIM_FLAG_Update);
    TIM_ITConfig(TIM4, TIM_IT_Update, ENABLE);

    NVIC_PriorityGroupConfig(NVIC_PriorityGroup_2);

    NVIC_InitStructure.NVIC_IRQChannel = TIM4_IRQn;
    NVIC_InitStructure.NVIC_IRQChannelCmd = ENABLE;
    NVIC_InitStructure.NVIC_IRQChannelPreemptionPriority = 2;
    NVIC_InitStructure.NVIC_IRQChannelSubPriority = 2;
    NVIC_Init(&NVIC_InitStructure);

    TIM_Cmd(TIM4, ENABLE);
}

uint32_t App_Millis(void)
{
    return sys_tick_ms;
}

void TIM4_IRQHandler(void)
{
    if (TIM_GetITStatus(TIM4, TIM_IT_Update) == SET)
    {
        sys_tick_ms++;
        TIM_ClearITPendingBit(TIM4, TIM_IT_Update);
    }
}
