rikaken2004/stm32-counter-motor-control_V3.0/(commit log)

2026-05-27 第一次复刻
2026-06-08 项目完善整理
2026-06-08 Enhance README with PCB design visuals
    Added PCB design 3D preview and top layer design images to README.
2026-06-08 删除媒体文件
2026-06-13 增加功能性代码
2026-06-13 linux和esp2文档整理发布
2026-06-19 esp32功能拓展
2026-06-19 下一版pcb设计规划
